shreyaspotnis/mini_pid/README.md

# mini_pid

A dual Proportional - Integral servo box
