shreyaspotnis/mini_pid/mini_pid.kicad_pcb

## KiCad design mini_pid.kicad_pcb (2017-03-14)

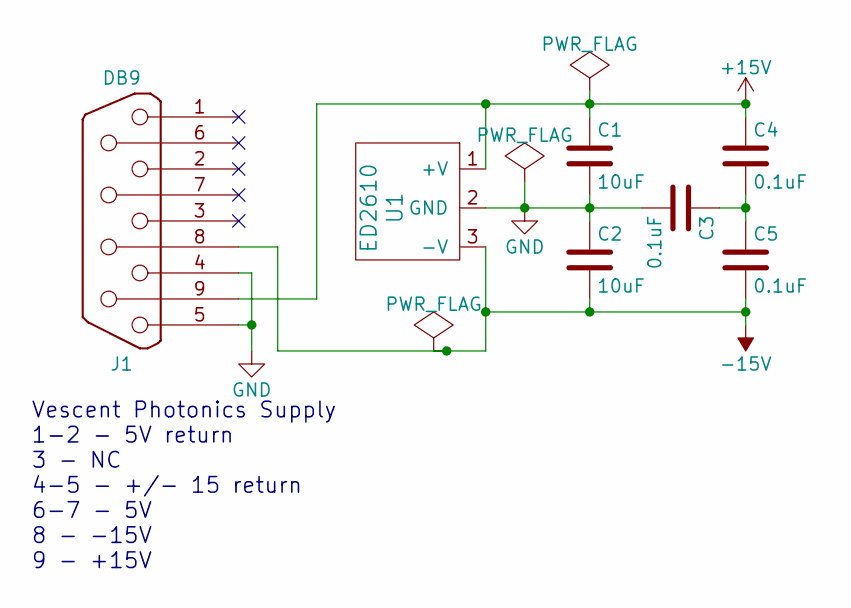
[picture p1: schematic file58C3664B.sch]

Parts:
C1, C2: 10uF; C_0805_HandSoldering
C3, C4, C5: 0.1uF; C_0805_HandSoldering
J1: DB9; DB9_Throughhole
U1: ED2610

Connections:
+15V: C1.1, C4.1, J1.9, U1.1 (+V); also elsewhere on the board
-15V: C2.2, C5.2, J1.8, U1.3 (-V); also elsewhere on the board
GND: C1.2, C2.1, C3.2, J1.4, J1.5, U1.2 (GND); also elsewhere on the board
unnamed: C3.1, C4.2, C5.1

Notes on the sheet:
Vescent Photonics Supply 1-2 - 5V return 3 - NC 4-5 - +/- 15 return 6-7 - 5V 8 - -15V 9 - +15V

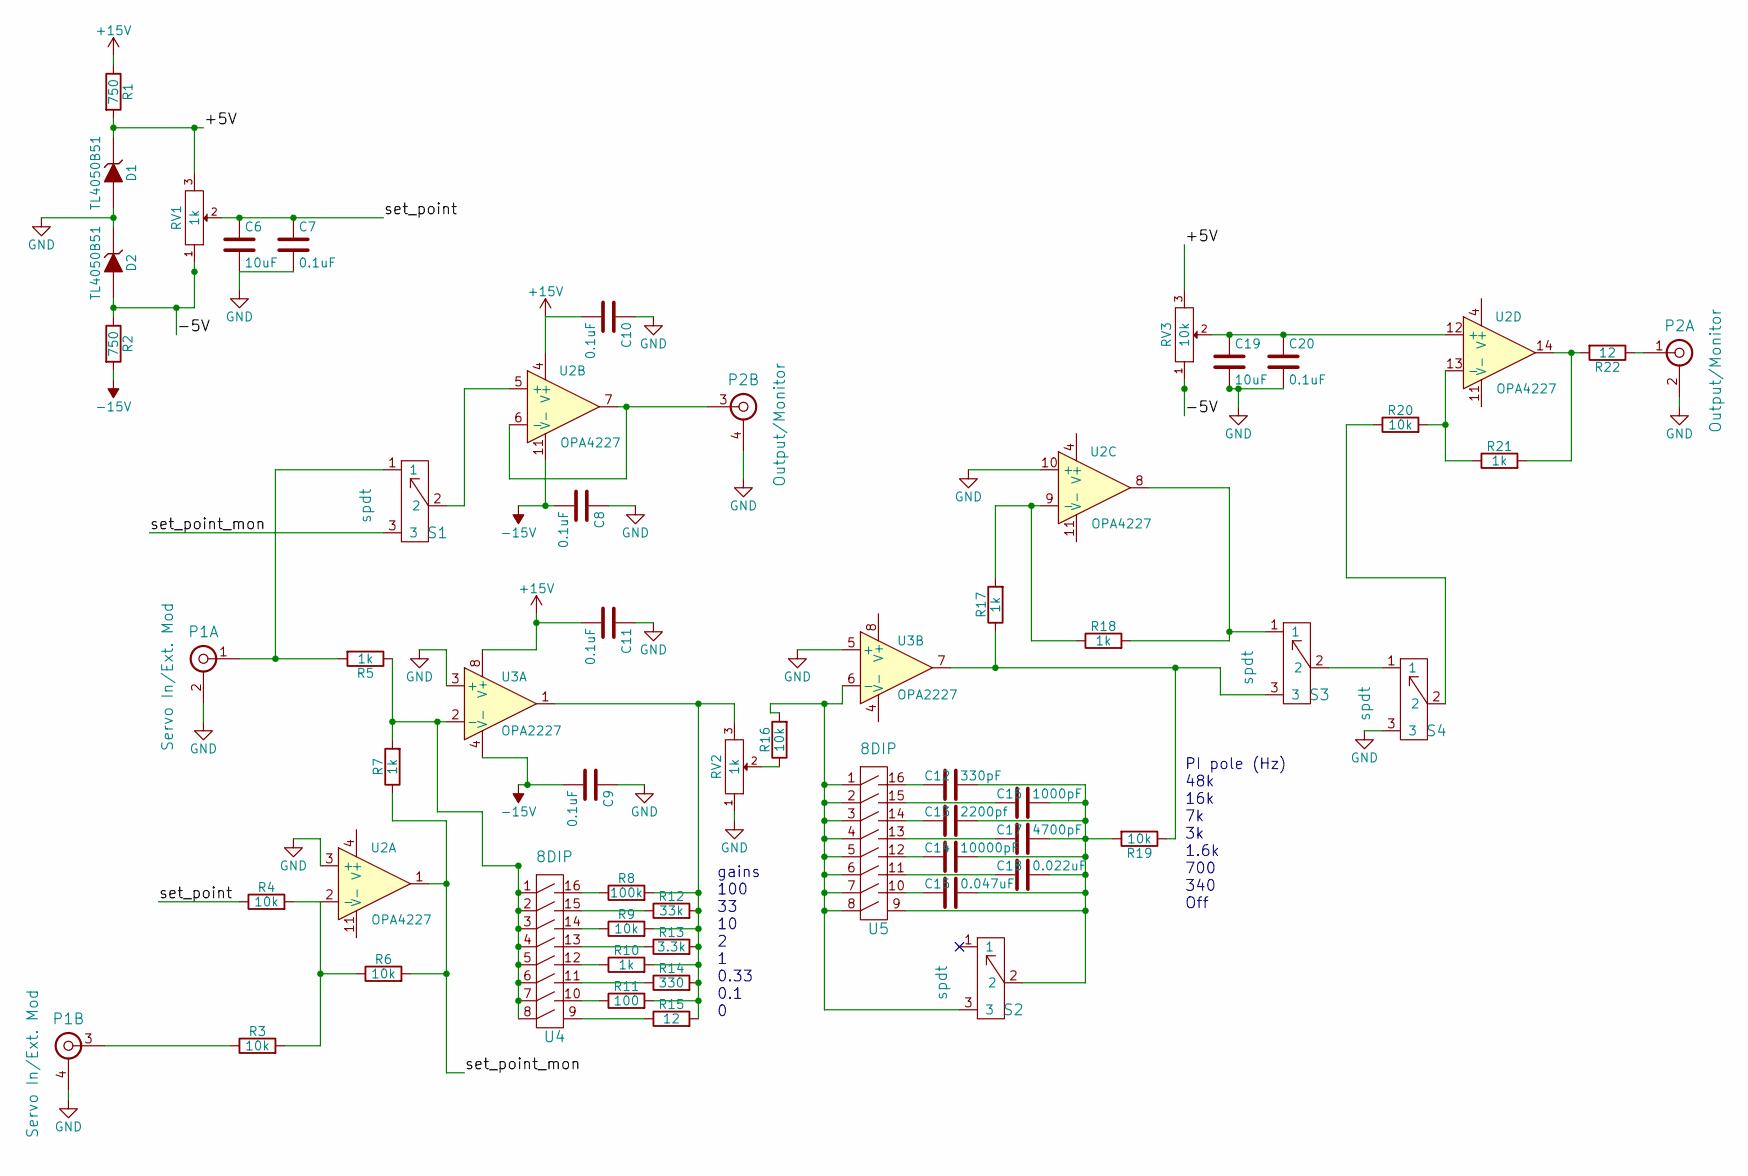
[picture p2: schematic file58C404B6.sch]

Parts:
C6, C19: 10uF; C_0805_HandSoldering
C7, C8, C9, C10, C11, C20: 0.1uF; C_0805_HandSoldering
C12: 330pF; C_0805_HandSoldering
C13: 2200pf; C_0805_HandSoldering
C14: 10000pF; C_0805_HandSoldering
C15: 0.047uF; C_0805_HandSoldering
C16: 1000pF; C_0805_HandSoldering
C17: 4700pF; C_0805_HandSoldering
C18: 0.022uF; C_0805_HandSoldering
D1, D2: TL4050B51; SOT-23
P1: Servo In/Ext. Mod; Dual-BNC-ARF2136
P2: Output/Monitor; Dual-BNC-ARF2136
R1, R2: 750; R_0805_HandSoldering
R3, R4, R6, R9, R16, R19, R20: 10k; R_0805_HandSoldering
R5, R7, R10, R17, R18, R21: 1k; R_0805_HandSoldering
R8: 100k; R_0805_HandSoldering
R11: 100; R_0805_HandSoldering
R12: 33k; R_0805_HandSoldering
R13: 3.3k; R_0805_HandSoldering
R14: 330; R_0805_HandSoldering
R15, R22: 12; R_0805_HandSoldering
RV1, RV2: 1k; VishaySpectrol536
RV3: 10k; VishaySpectrol536
S1, S2, S4: spdt; SPDT-Horizontal
S3: spdt; CJS-1200TB-SPDT
U2: OPA4227; SOIC-14_3.9x8.7mm_Pitch1.27mm
U3: OPA2227; SOIC-8_3.9x4.9mm_Pitch1.27mm
U4, U5: 8DIP; 8_POS_DIP_Switch

Connections:
+15V: C10.2, C11.2, R1.1, U2.4 (V+), U3.8 (V+); also elsewhere on the board
-15V: C8.2, C9.2, R2.2, U2.11 (V-), U3.4 (V-); also elsewhere on the board
/PI Circuit 1/+5V: D1.1 (K), R1.2, RV1.3, RV3.3
/PI Circuit 1/-5V: D2.2 (A), R2.1, RV1.1, RV3.1
/PI Circuit 1/set_point: C6.1, C7.1, R4.1, RV1.2
/PI Circuit 1/set_point_mon: R6.2, R7.1, S1.3, U2.1
GND: C6.2, C7.2, C8.1, C9.1, C10.1, C11.1, C19.2, C20.2, D1.2 (A), D2.1 (K), P1.2, P1.4, P2.2, P2.4, RV2.1, S4.3, U2.3 (+), U2.10 (+), U3.3 (+), U3.5 (+); also elsewhere on the board
unnamed: C12.1, C13.1, C14.1, C15.1, C16.1, C17.1, C18.1, R19.2, S2.2, U5.9
unnamed: C12.2, U5.16
unnamed: C13.2, U5.14
unnamed: C14.2, U5.12
unnamed: C15.2, U5.10
unnamed: C16.2, U5.15
unnamed: C17.2, U5.13
unnamed: C18.2, U5.11
unnamed: C19.1, C20.1, RV3.2, U2.12 (+)
unnamed: P1.1, R5.2, S1.1
unnamed: P1.3, R3.1
unnamed: P2.1, R22.1
unnamed: P2.3, U2.6 (-), U2.7
unnamed: R3.2, R4.2, R6.1, U2.2 (-)
unnamed: R5.1, R7.2, U3.2 (-), U4.1, U4.2, U4.3, U4.4, U4.5, U4.6, U4.7, U4.8
unnamed: R8.1, U4.16
unnamed: R9.1, U4.14
unnamed: R10.1, U4.12
unnamed: R8.2, R9.2, R10.2, R11.2, R12.2, R13.2, R14.2, R15.2, RV2.3, U3.1
unnamed: R11.1, U4.10
unnamed: R12.1, U4.15
unnamed: R13.1, U4.13
unnamed: R14.1, U4.11
unnamed: R15.1, U4.9
unnamed: R16.1, RV2.2
unnamed: R16.2, S2.3, U3.6 (-), U5.1, U5.2, U5.3, U5.4, U5.5, U5.6, U5.7, U5.8
unnamed: R17.1, R19.1, S3.3, U3.7
unnamed: R17.2, R18.1, U2.9 (-)
unnamed: R18.2, S3.1, U2.8
unnamed: R20.1, S4.2
unnamed: R20.2, R21.1, U2.13 (-)
unnamed: R21.2, R22.2, U2.14
unnamed: S1.2, U2.5 (+)
unnamed: S3.2, S4.1

Notes on the sheet:
gains 100 33 10 2 1 0.33 0.1 0
PI pole (Hz) 48k 16k 7k 3k 1.6k 700 340 Off

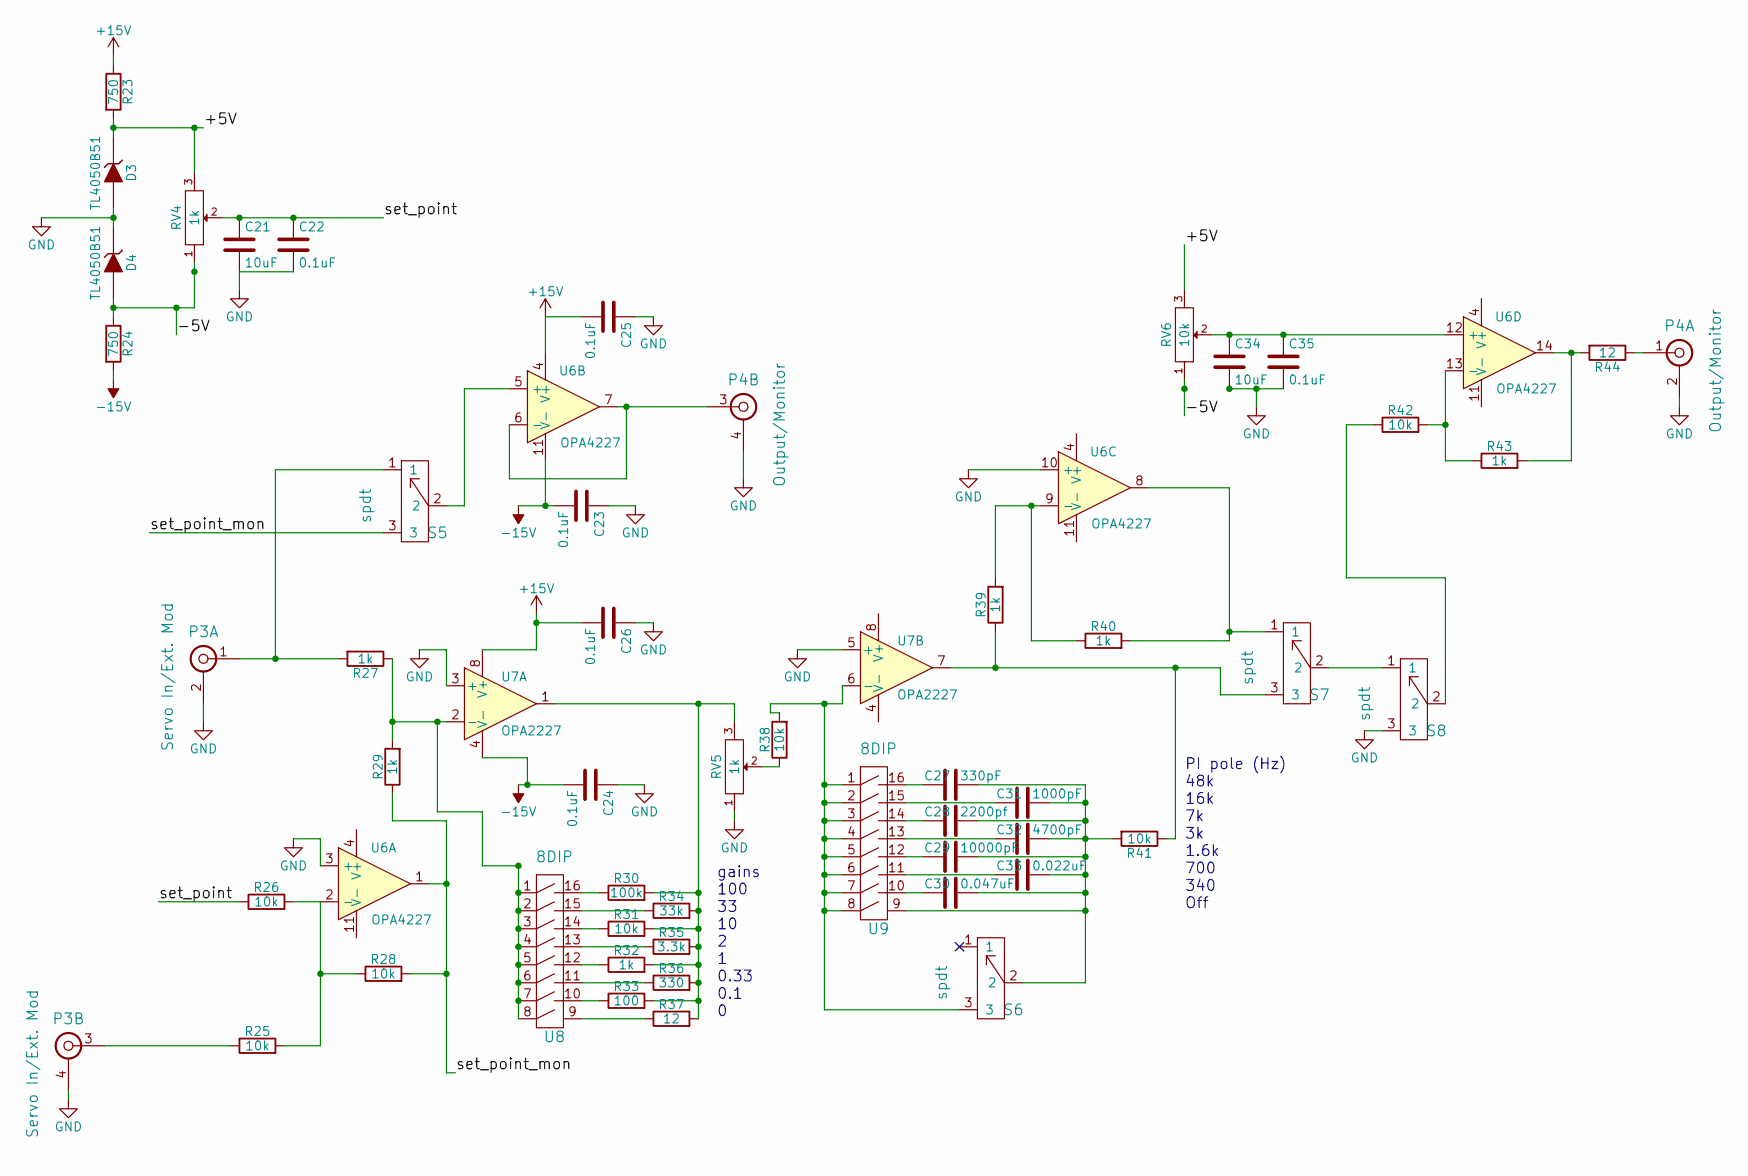
[picture p3: schematic file58C423FA.sch]

Parts:
C21, C34: 10uF; C_0805_HandSoldering
C22, C23, C24, C25, C26, C35: 0.1uF; C_0805_HandSoldering
C27: 330pF; C_0805_HandSoldering
C28: 2200pf; C_0805_HandSoldering
C29: 10000pF; C_0805_HandSoldering
C30: 0.047uF; C_0805_HandSoldering
C31: 1000pF; C_0805_HandSoldering
C32: 4700pF; C_0805_HandSoldering
C33: 0.022uF; C_0805_HandSoldering
D3, D4: TL4050B51; SOT-23
P3: Servo In/Ext. Mod; Dual-BNC-ARF2136
P4: Output/Monitor; Dual-BNC-ARF2136
R23, R24: 750; R_0805_HandSoldering
R25, R26, R28, R31, R38, R41, R42: 10k; R_0805_HandSoldering
R27, R29, R32, R39, R40, R43: 1k; R_0805_HandSoldering
R30: 100k; R_0805_HandSoldering
R33: 100; R_0805_HandSoldering
R34: 33k; R_0805_HandSoldering
R35: 3.3k; R_0805_HandSoldering
R36: 330; R_0805_HandSoldering
R37, R44: 12; R_0805_HandSoldering
RV4, RV5: 1k; VishaySpectrol536
RV6: 10k; VishaySpectrol536
S5, S6, S8: spdt; SPDT-Horizontal
S7: spdt; CJS-1200TB-SPDT
U6: OPA4227; SOIC-14_3.9x8.7mm_Pitch1.27mm
U7: OPA2227; SOIC-8_3.9x4.9mm_Pitch1.27mm
U8, U9: 8DIP; 8_POS_DIP_Switch

Connections:
+15V: C25.2, C26.2, R23.1, U6.4 (V+), U7.8 (V+); also elsewhere on the board
-15V: C23.2, C24.2, R24.2, U6.11 (V-), U7.4 (V-); also elsewhere on the board
/PI Circuit 2/+5V: D3.1 (K), R23.2, RV4.3, RV6.3
/PI Circuit 2/-5V: D4.2 (A), R24.1, RV4.1, RV6.1
/PI Circuit 2/set_point: C21.1, C22.1, R26.1, RV4.2
/PI Circuit 2/set_point_mon: R28.2, R29.1, S5.3, U6.1
GND: C21.2, C22.2, C23.1, C24.1, C25.1, C26.1, C34.2, C35.2, D3.2 (A), D4.1 (K), P3.2, P3.4, P4.2, P4.4, RV5.1, S8.3, U6.3 (+), U6.10 (+), U7.3 (+), U7.5 (+); also elsewhere on the board
unnamed: C27.1, C28.1, C29.1, C30.1, C31.1, C32.1, C33.1, R41.2, S6.2, U9.9
unnamed: C27.2, U9.16
unnamed: C28.2, U9.14
unnamed: C29.2, U9.12
unnamed: C30.2, U9.10
unnamed: C31.2, U9.15
unnamed: C32.2, U9.13
unnamed: C33.2, U9.11
unnamed: C34.1, C35.1, RV6.2, U6.12 (+)
unnamed: P3.1, R27.2, S5.1
unnamed: P3.3, R25.1
unnamed: P4.1, R44.1
unnamed: P4.3, U6.6 (-), U6.7
unnamed: R25.2, R26.2, R28.1, U6.2 (-)
unnamed: R27.1, R29.2, U7.2 (-), U8.1, U8.2, U8.3, U8.4, U8.5, U8.6, U8.7, U8.8
unnamed: R30.1, U8.16
unnamed: R30.2, R31.2, R32.2, R33.2, R34.2, R35.2, R36.2, R37.2, RV5.3, U7.1
unnamed: R31.1, U8.14
unnamed: R32.1, U8.12
unnamed: R33.1, U8.10
unnamed: R34.1, U8.15
unnamed: R35.1, U8.13
unnamed: R36.1, U8.11
unnamed: R37.1, U8.9
unnamed: R38.1, RV5.2
unnamed: R38.2, S6.3, U7.6 (-), U9.1, U9.2, U9.3, U9.4, U9.5, U9.6, U9.7, U9.8
unnamed: R39.1, R41.1, S7.3, U7.7
unnamed: R39.2, R40.1, U6.9 (-)
unnamed: R40.2, S7.1, U6.8
unnamed: R42.1, S8.2
unnamed: R42.2, R43.1, U6.13 (-)
unnamed: R43.2, R44.2, U6.14
unnamed: S5.2, U6.5 (+)
unnamed: S7.2, S8.1

Notes on the sheet:
gains 100 33 10 2 1 0.33 0.1 0
PI pole (Hz) 48k 16k 7k 3k 1.6k 700 340 Off

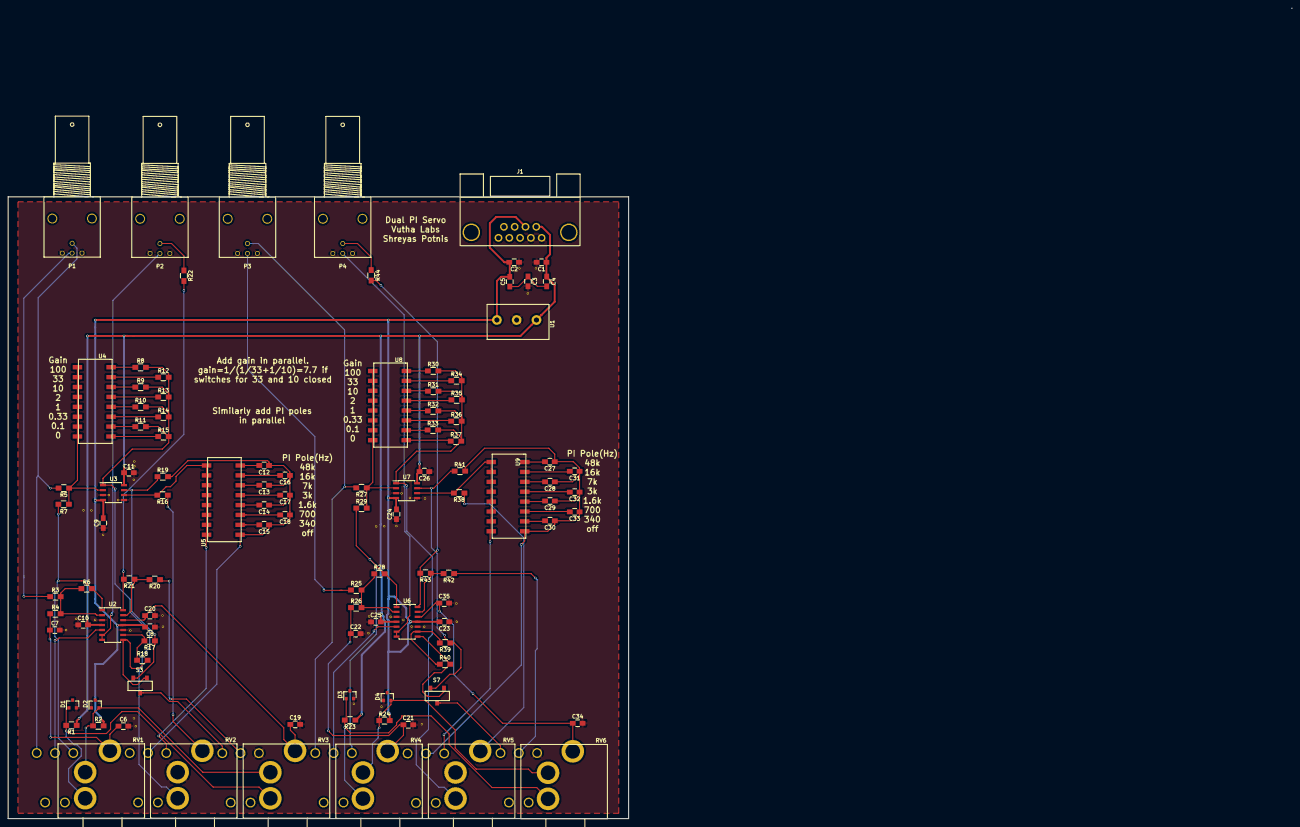
[picture p4: board mini_pid.kicad_pcb from above]

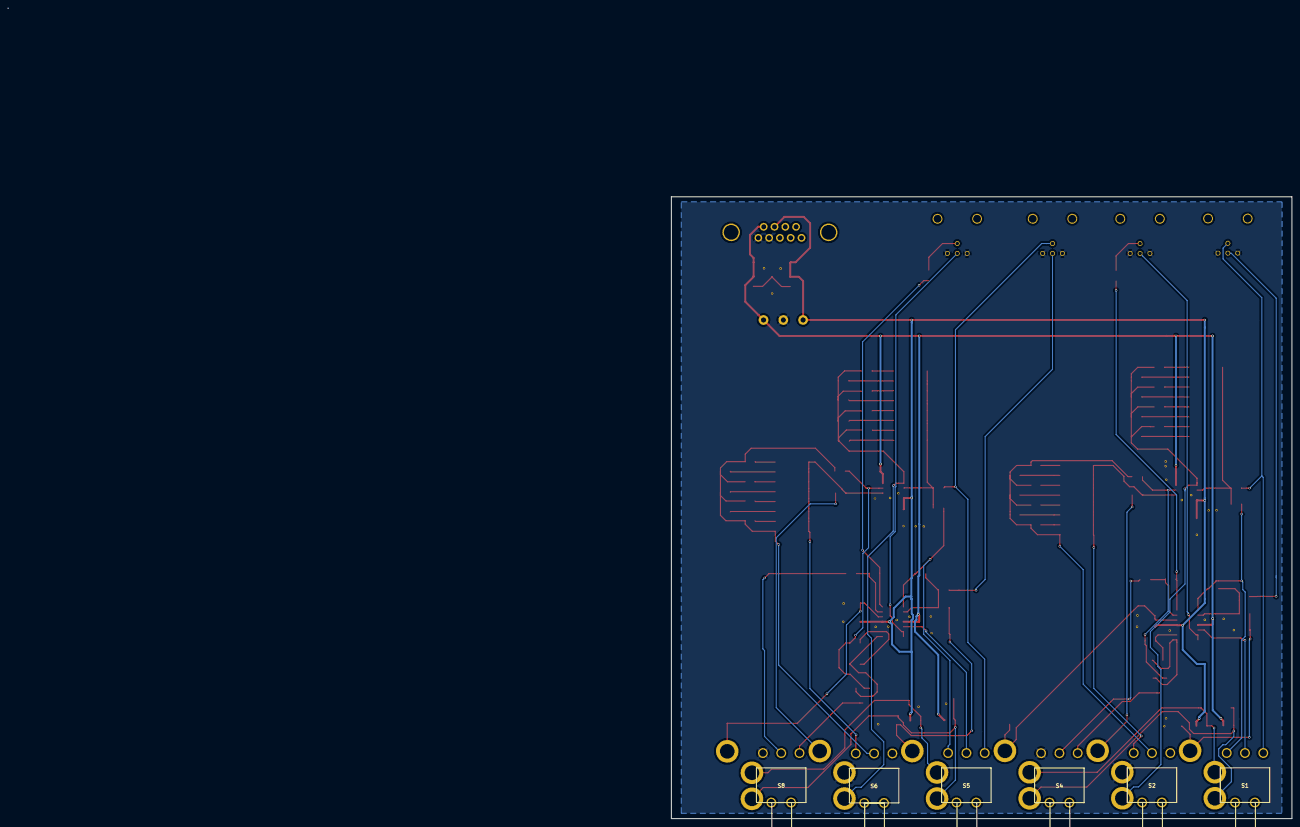
[picture p5: board mini_pid.kicad_pcb from below]

Board: 2 copper layers, 159.3 x 159.7 mm, 111 parts (6 on the bottom side), 80 nets.
