shreyaspotnis/mini_pid/(commit log)

2017-03-07 Started layout out traces
    [_saved_mini_pid.sch, mini_pid.kicad_pcb, mini_pid.sch]
2017-03-08 Layout for old version completed
    [_saved_mini_pid.sch, mini_pid.kicad_pcb, mini_pid.sch]
2017-03-09 Project is now dual PID :)
    [file58C3664B.sch, file58C404B6.sch, file58C423FA.sch, mini_pid.sch]
2017-03-13 Schematic complete
    [file58C3664B.sch, file58C404B6.sch, file58C423FA.sch, mini_pid.sch]
2017-03-13 Made both circiuts identical
    [file58C3664B.sch, file58C404B6.sch, file58C423FA.sch, mini_pid.sch]
2017-03-13 Footprints assigned
    [file58C3664B.sch, file58C404B6.sch, file58C423FA.sch]
2017-03-13 Reset board layout
    [mini_pid.kicad_pcb]
2017-03-13 Board connectors placed
    [_saved_file58C423FA.sch, file58C3664B.sch, file58C404B6.sch, mini_pid.kicad_pcb]
2017-03-13 PI circuit 1 done
    [_saved_file58C423FA.sch, file58C404B6.sch, file58C423FA.sch, mini_pid.kicad_pcb]
2017-03-14 Track routing done.
    [file58C3664B.sch, file58C404B6.sch, file58C423FA.sch, mini_pid.kicad_pcb, mini_pid.sch]
2017-03-14 Added ground planes, fixed unconnected nets.
    [mini_pid.kicad_pcb]
2017-03-14 Almost done, but rewiring for optimization
    [mini_pid.kicad_pcb]
2017-03-14 Spaced out components
    [mini_pid.kicad_pcb]
2017-03-14 Interactive routing FTW. PI circuit 1 done.
    [mini_pid.kicad_pcb]
2017-03-14 Gerber and drill files created.
    [1-click-bom.tsv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]
